cure76/EFHW-transformator-box/README.md

# Корпус трансформатора EFHW под FT 240-43

Параметрические модели OpenSCAD: основание и крышка унна 1:49 / 1:64. Печать **PETG**.

## Файлы

| Файл | Кольца | SO-239 | Полость | Предел |
| --- | --- | --- | --- | --- |
| `efhw_box.scad` | 1 × FT 240-43 | квадрат, 4 × M3 | 85 × 108 × 38 мм | 250 Вт SSB PEP, 120 Вт CW, 90 Вт FT8 |
| `efhw_box_rhomb.scad` | 1 × FT 240-43 | ромбический, 2 × M3, база 25 мм | 85 × 108 × 38 мм | 250 Вт SSB PEP, 120 Вт CW, 90 Вт FT8 |
| `efhw_box_2x.scad` | 2 × FT 240-43 стопкой | квадрат, 4 × M3 | 85 × 108 × 50 мм | 500 Вт SSB PEP, 250 Вт CW, 180 Вт FT8 |
| `efhw_box_2x_rhomb.scad` | 2 × FT 240-43 стопкой | ромбический, 2 × M3, база 25 мм | 85 × 108 × 50 мм | 500 Вт SSB PEP, 250 Вт CW, 180 Вт FT8 |

Без внешних библиотек.

- `part = "preview"` — сборка на экране
- `part = "base"` — основание
- `part = "lid"` — крышка (внутренней стороной на стол, надпись сверху)
- `part = "plug"` — заглушка неиспользуемого отверстия M4 (фланцем на стол)
- `ratio = 64` (по умолчанию) или `49` — на крышке `1:64` / `1:49` и строка мощности

## Полость

Одно кольцо: ПЭТВ-2 **1.25 мм**, запас под **1.5 мм**, фланец SO-239 25.4 мм. Габарит намотки Ø79 × 22 мм не должен задевать стойки.

Два кольца: та же ширина и длина, высота полости 50 мм под стопку 25.4 мм плюс намотка (ориентир Ø79 × 34 мм).

Кольца лежат плашмя, без клипс. По желанию — капля силикона в центр отверстия.

```
[хвост, 3 × Ø8 мм] [==== полость, кольцо плашмя ====] [SO-239 вниз]
                         [M4 сбоку ±Y, ближе к хвосту]
                         [крышка сверху, 4 × M4×10 потай]
                         [дренаж в торце SO-239]
```

В работе корпус висит за хвост, разъём смотрит вниз.

## Печать (PETG)

- Слой 0.2 мм, не меньше 3 периметров (стенка 2.8 мм)
- Основание: полостью вверх. Жёлоб, стойки и хвост — без поддержек
- Крышка 3.6 мм: внутренней стороной на стол, надпись и потай сверху. Утопление букв — в последних слоях
- Заглушка M4: фланцем на стол, стержень вверх, без поддержек
- Отверстия уже в модели, не сверлить после печати

Герметизация: валик нейтрального силикона в жёлобе плюс свес крышки как капельник. Нависающей юбки по шву нет.

## Саморезы крышки

Четыре **M4 × 10 с плоской потайной головкой 90°** (DIN 965 / ISO 7046). Длина 10 мм считается вместе со шляпкой; в крышке зенковка, шляпка заподлицо. Полукруглые и с прессшайбой в эту зенковку не сядут.

Пилот в стойках Ø 3.2 мм, под саморез в PETG, не под метрическую резьбу.

## Сборка

1. Вставить корпусной SO-239: квадратный фланец — 4 × M3, ромбический — 2 × M3 (в PETG только зазоры).
2. Вставить M4 изнутри через прилив на **одной** боковой стенке; снаружи шайба и гайка после пайки полотна. Второе отверстие закрыть заглушкой снаружи (фланец наружу); по желанию капля силикона под фланец.
3. Положить намотанное кольцо (или стопку).
4. Пайка: центральный пин, земля фланца, отвод на M4.
5. Валик нейтрального силикона в жёлоб по кромке.
6. Крышка, 4 самореза M4 × 10 с плоской (потайной) головкой в стойки (пилот Ø 3.2 мм). Шляпка заподлицо.
7. Два дренажных отверстия в торце SO-239 не замазывать.

Противовеса на корпусе нет.

## Мощность

| Файл | SSB PEP | CW | FT8 | Надпись на крышке |
| --- | --- | --- | --- | --- |
| `efhw_box.scad` | 250 Вт | 120 Вт | 90 Вт | `250W SSB PEP` |
| `efhw_box_rhomb.scad` | 250 Вт | 120 Вт | 90 Вт | `250W SSB PEP` |
| `efhw_box_2x.scad` | 500 Вт | 250 Вт | 180 Вт | `500W SSB PEP` |
| `efhw_box_2x_rhomb.scad` | 500 Вт | 250 Вт | 180 Вт | `500W SSB PEP` |

## Тесты

```bash
python3 tests/test_efhw_box.py
```

OpenSCAD CLI необязателен: без него проверки CSG/STL пропускаются.

## Лицензия

[BSD 3-Clause](LICENSE).
