cure76/EFHW-transformator-box/efhw_box.scad

// EFHW unun box for FT 240-43 — PETG FDM

part = "preview"; // "base" | "lid" | "plug" | "preview"
ratio = 64;       // 64 or 49

inner_x = 108;
inner_y = 85;
inner_z = 38;
wall = 2.8;
floor_t = 2.8;
lid_t = 3.6;              // thicker than walls so the 90° CSK is not a knife edge

// Top mating face must be wider than wall so a 4 mm trough fits.
rim_w = 7;
flange_out = rim_w - wall; // 4.2 mm outward lip
trough_w = 4;
trough_d = 1;

corner_r = 8;
chamfer = 14;
fit_clearance = 0.25;

// Four M4×10 countersunk (flat-head) self-tappers. Length includes the head.
boss_d = 12;
boss_pilot_d = 3.2;
boss_pilot_depth = 10;
lid_screw_d = 4.0;
lid_csink_d = 9.0;         // DIN 965 M4 head max 8.4 mm + print
lid_csink_h = 2.3;         // 90° CSK, flush in lid_t
skirt_t = 1.6;
skirt_gap = 0.3;

tab_len = 30;
tab_t = 8;                 // hanging plate thickness (was wall = 2.8)
tab_center_hole_d = 8;
tab_side_hole_d = 8;

drain_d = 3;
// Max |Y| on the flat +X face, hole fully on the wall (not on the 45° chamfer).
drain_y_off = inner_y / 2 - chamfer - drain_d / 2 - 1.5;

so_flange = 25.4;
so_hole_spacing = 18.2;
so_barrel_d = 16.3;
so_screw_d = 3.2;
so_pad_t = 2.5;

m4_d = 4.0;
m4_from_tail_inner = 18;
m4_toward_so239 = 5;       // along +X, toward the connector
m4_pad_t = 2;              // extra thickness inward, no hex pocket
m4_pad_d = 14;
m4_plug_flange_d = 10;
m4_plug_flange_t = 1.6;
m4_plug_press = 0.2;       // shaft over the cutout so the plug holds itself
m4_plug_extra_h = 2;       // extra length past the inner pad

// FR4 0.5 mm standoffs. M3×6 pan-head self-tappers; blind pilot, not through the floor.
fr4_boss_d = 16;
fr4_boss_h = 6;
fr4_pilot_d = 2.5;
fr4_pilot_depth = 4;
fr4_boss_x = 34;           // 80 mm jig, 6 mm from left/right
fr4_boss_y = 21.5;         // 55 mm jig, 6 mm from top/bottom
fr4_lid_clear = 0.5;       // keep pads off the lid-screw posts

label_depth = 0.6;
label_size_ratio = 12;
label_size_power = 6;

$fn = 48;

function outer_x() = inner_x + 2 * wall + 2 * flange_out;
function outer_y() = inner_y + 2 * wall + 2 * flange_out;
function wall_x() = inner_x + 2 * wall;
function wall_y() = inner_y + 2 * wall;
function base_h() = floor_t + inner_z;
function flange_h() = 3.0;
function boss_inset() = boss_d / 2 + 1.5;

// Same 1.5 mm gap to both faces of the corner as at the tail.
function so239_boss_xy(sy) =
    let (
        inset = boss_inset(),
        cy = sy * (inner_y / 2 - inset),
        cx = inner_x / 2 + inner_y / 2 - chamfer
            - abs(cy) - inset * sqrt(2)
    ) [cx, cy];

function tail_boss_xy(sy) =
    [-inner_x / 2 + boss_inset(), sy * (inner_y / 2 - boss_inset())];

function boss_centres() = [
    so239_boss_xy(1),
    so239_boss_xy(-1),
    tail_boss_xy(1),
    tail_boss_xy(-1)
];

module body_outline(h) {
    linear_extrude(height = h)
        offset(delta = wall + flange_out)
            chamfered_profile();
}

// Every mating perimeter is a true offset of this inner cavity profile.
module chamfered_profile() {
    inner_corner_r = max(0.1, corner_r - wall);
    offset(r = inner_corner_r)
        offset(delta = -inner_corner_r)
            polygon([
                [-inner_x / 2, -inner_y / 2],
                [ inner_x / 2 - chamfer, -inner_y / 2],
                [ inner_x / 2, -inner_y / 2 + chamfer],
                [ inner_x / 2,  inner_y / 2 - chamfer],
                [ inner_x / 2 - chamfer,  inner_y / 2],
                [-inner_x / 2,  inner_y / 2]
            ]);
}

module wall_outline(h) {
    linear_extrude(height = h)
        offset(delta = wall)
            chamfered_profile();
}

module inner_outline(h) {
    linear_extrude(height = h)
        chamfered_profile();
}

module cavity() {
    translate([0, 0, floor_t])
        inner_outline(inner_z + 1);
}

module fr4_bosses() {
    // Four pads on the floor for a 0.5 mm FR4 sheet. Screw heads sit outside
    // the FT 240 winding; the core rests on the sheet between them.
    // Same XY as the 80×55 mm drill jig (6 mm from every plate edge).
    // Pads are kept clear of the lid-screw posts.
    for (sx = [-1, 1], sy = [-1, 1]) {
        p = [sx * fr4_boss_x, sy * fr4_boss_y];
        difference() {
            translate([0, 0, floor_t - 0.02])
                linear_extrude(height = fr4_boss_h + 0.02)
                    intersection() {
                        chamfered_profile();
                        difference() {
                            translate(p)
                                circle(d = fr4_boss_d);
                            for (b = boss_centres())
                                translate(b)
                                    circle(d = boss_d + 2 * fr4_lid_clear);
                        }
                    }
            translate([p[0], p[1], floor_t + fr4_boss_h - fr4_pilot_depth])
                cylinder(d = fr4_pilot_d, h = fr4_pilot_depth + 0.2);
        }
    }
}

module screw_bosses() {
    h = inner_z - trough_d;
    // Kite: boss circle plus two tangent ramps to the adjacent walls.
    // Anchors are points, not boss-diameter circles — a fat circle on the
    // +X chamfer vertex used to cover the drain mouths.
    posts = [
        [so239_boss_xy(1), [
            [inner_x / 2 - chamfer,  inner_y / 2],
            [inner_x / 2,            inner_y / 2 - chamfer]
        ]],
        [so239_boss_xy(-1), [
            [inner_x / 2 - chamfer, -inner_y / 2],
            [inner_x / 2,           -inner_y / 2 + chamfer]
        ]],
        [tail_boss_xy(1),  [[-inner_x / 2,  inner_y / 2]]],
        [tail_boss_xy(-1), [[-inner_x / 2, -inner_y / 2]]]
    ];

    for (post = posts) {
        pos = post[0];
        anchors = post[1];
        difference() {
            translate([0, 0, floor_t - 0.02])
                linear_extrude(height = h + 0.02)
                    intersection() {
                        chamfered_profile();
                        hull() {
                            translate(pos)
                                circle(d = boss_d);
                            for (a = anchors)
                                translate(a)
                                    circle(d = 0.02);
                        }
                    }
            translate([pos[0], pos[1], floor_t + h - boss_pilot_depth])
                cylinder(d = boss_pilot_d, h = boss_pilot_depth + 0.2);
        }
    }
}

module sealant_trough() {
    land = (rim_w - trough_w) / 2;
    translate([0, 0, base_h() - trough_d])
        difference() {
            linear_extrude(height = trough_d + 0.2)
                offset(delta = wall + flange_out - land)
                    chamfered_profile();
            linear_extrude(height = trough_d + 0.4)
                offset(delta = wall + flange_out - land - trough_w)
                    chamfered_profile();
        }
}

module mounting_tab() {
    // Full-width rear flange, thicker than the wall, clover tip with 3 holes.
    x_wall = -wall_x() / 2;
    x_tip = x_wall - tab_len;
    y_h = wall_y() / 2;
    side_y = y_h - 12;

    difference() {
        hull() {
            // Root spans the whole −X wall and bites into it.
            translate([x_wall + 4, 0, tab_t / 2])
                cube([8, wall_y(), tab_t], center = true);
            translate([x_wall, y_h - 8, 0])
                cylinder(d = 16, h = tab_t);
            translate([x_wall, -y_h + 8, 0])
                cylinder(d = 16, h = tab_t);
            // Rounded clover across the full width.
            translate([x_tip + 12, 0, 0])
                cylinder(d = 24, h = tab_t);
            translate([x_tip + 14, side_y, 0])
                cylinder(d = 20, h = tab_t);
            translate([x_tip + 14, -side_y, 0])
                cylinder(d = 20, h = tab_t);
        }
        translate([x_tip + 11, 0, -0.1])
            cylinder(d = tab_center_hole_d, h = tab_t + 0.2);
        translate([x_tip + 14, side_y, -0.1])
            cylinder(d = tab_side_hole_d, h = tab_t + 0.2);
        translate([x_tip + 14, -side_y, -0.1])
            cylinder(d = tab_side_hole_d, h = tab_t + 0.2);
    }
}

module drain_holes() {
    // Through the SO-239 end wall, left and right of the connector.
    // When the box hangs from the tab, that face is the lowest point.
    zc = floor_t + inner_z / 2;
    x_wall = inner_x / 2;
    for (s = [-1, 1]) {
        translate([x_wall - 1, s * drain_y_off, zc])
            rotate([0, 90, 0])
                cylinder(d = drain_d, h = wall + 2);
        translate([x_wall + wall + 0.01, s * drain_y_off, zc])
            rotate([0, -90, 0])
                cylinder(d1 = drain_d + 2, d2 = drain_d, h = 1.2);
    }
}

module so239_cutout() {
    zc = floor_t + inner_z / 2;
    x_wall = inner_x / 2;
    barrel = so_barrel_d + 2 * fit_clearance;
    screw = so_screw_d + 2 * fit_clearance;
    hs = so_hole_spacing / 2;
    through_h = so_pad_t + wall + 2;

    // Barrel through the inward pad and 2.8 mm +X wall.
    translate([x_wall - so_pad_t - 1, 0, zc])
        rotate([0, 90, 0])
            cylinder(d = barrel, h = through_h);
    // Four M3 clearance holes matching the square SO-239 flange.
    for (a = [-1, 1], b = [-1, 1]) {
        translate([x_wall - so_pad_t - 1, a * hs, zc + b * hs])
            rotate([0, 90, 0])
                cylinder(d = screw, h = through_h);
    }
}

module so239_pad() {
    zc = floor_t + inner_z / 2;
    x_wall = inner_x / 2;
    pad_size = so_flange + 0.4;

    // Full flange seat grows inward from the +X wall into the cavity.
    translate([x_wall - so_pad_t, -pad_size / 2, zc - pad_size / 2])
        cube([so_pad_t + 0.01, pad_size, pad_size]);
}

module m4_pad() {
    zc = floor_t + inner_z / 2;
    x = -inner_x / 2 + m4_from_tail_inner + m4_toward_so239;

    // Inward bosses on both ±Y walls; holes are cut later through pad + wall.
    for (sy = [-1, 1]) {
        y_inner = sy * inner_y / 2;
        translate([x, y_inner + sy * 0.01, zc])
            rotate([sy * 90, 0, 0])
                cylinder(d = m4_pad_d, h = m4_pad_t + 0.01);
    }
}

module m4_cutout() {
    zc = floor_t + inner_z / 2;
    x = -inner_x / 2 + m4_from_tail_inner + m4_toward_so239;
    shank = m4_d + 2 * fit_clearance;
    through_h = wall + m4_pad_t + 2;

    for (sy = [-1, 1]) {
        y_inner = sy * inner_y / 2;
        translate([x, y_inner + sy * (wall + 1), zc])
            rotate([sy * 90, 0, 0])
                cylinder(d = shank, h = through_h);
    }
}

module m4_plug() {
    // Print flange on the bed, shaft up. Push in from outside; flange sheds rain.
    // Shaft is a press fit in the M4 cutout; a short taper starts the insertion.
    hole = m4_d + 2 * fit_clearance;
    shaft = hole + m4_plug_press;
    shaft_h = wall + m4_pad_t + m4_plug_extra_h;
    cylinder(d = m4_plug_flange_d, h = m4_plug_flange_t);
    translate([0, 0, m4_plug_flange_t - 0.01])
        cylinder(d = shaft, h = shaft_h + 0.01);
    translate([0, 0, m4_plug_flange_t + shaft_h - 0.01])
        cylinder(d1 = shaft, d2 = hole - 0.3, h = 1.5);
}

module m4_plug_on_wall(sy) {
    x = -inner_x / 2 + m4_from_tail_inner + m4_toward_so239;
    zc = floor_t + inner_z / 2;
    y_outer = sy * (inner_y / 2 + wall);
    translate([x, y_outer, zc])
        rotate([sy * 90, 0, 0])
            translate([0, 0, -m4_plug_flange_t])
                m4_plug();
}

module lid_label() {
    // Recessed into the outer face. Readable when tail (−X) is up:
    // rotate 90° so the baseline runs across the short axis, top of glyphs
    // toward −X.
    linear_extrude(height = label_depth + 0.1) {
        rotate([0, 0, 90]) {
            translate([0, 4, 0])
                text(
                    str("1:", ratio),
                    size = label_size_ratio,
                    halign = "center",
                    valign = "center"
                );
            translate([0, -8, 0])
                text(
                    "250W SSB PEP",
                    size = label_size_power,
                    halign = "center",
                    valign = "center"
                );
        }
    }
}

module so239_rim_clearance() {
    // Drop the outward lid-rim on the +X face so a 25.4 mm flange sits flat.
    w = so_flange + 6;
    translate([inner_x / 2 + wall, -w / 2, -0.1])
        cube([flange_out + 1, w, base_h() - flange_h() + 0.1]);
}

module base() {
    difference() {
        union() {
            difference() {
                wall_outline(base_h());
                cavity();
            }
            // Outward flange at the rim so trough_w=4 fits on a 2.8 mm wall.
            translate([0, 0, base_h() - flange_h()])
                difference() {
                    body_outline(flange_h());
                    inner_outline(flange_h() + 0.2);
                }
            screw_bosses();
            fr4_bosses();
            so239_pad();
            m4_pad();
        }
        sealant_trough();
        so239_rim_clearance();
        drain_holes();
        so239_cutout();
        m4_cutout();
    }
    mounting_tab();
}

module lid_shell() {
    difference() {
        // Plate overhangs the flange as a drip cap; there is no hanging wall.
        linear_extrude(height = lid_t)
            offset(delta = skirt_t + skirt_gap)
                projection() body_outline(1);
        lid_screw_holes();
        translate([0, 0, lid_t - label_depth])
            lid_label();
    }
}

module lid_screw_holes() {
    for (p = boss_centres()) {
        shank = lid_screw_d + 2 * fit_clearance;
        translate([p[0], p[1], -0.1])
            cylinder(d = shank, h = lid_t + 0.2);
        // 90° cone from the through-hole out to the flat head.
        translate([p[0], p[1], lid_t - lid_csink_h])
            cylinder(d1 = shank, d2 = lid_csink_d, h = lid_csink_h + 0.05);
    }
}

module lid() {
    lid_shell();
}

module preview_assembly() {
    color("DimGray") base();
    color("Gray")
        translate([0, 0, base_h() + 0.15])
            lid_shell();
    // Spare M4 hole on +Y closed by the printed plug; −Y is the radiator bolt.
    color("Orange") m4_plug_on_wall(1);
}

if (part == "base") {
    base();
} else if (part == "lid") {
    lid();
} else if (part == "plug") {
    m4_plug();
} else if (part == "preview") {
    preview_assembly();
}
