cure76/EFHW-transformator-box/(list of files, cad)

Other CAD files:
efhw_box_2x.scad
efhw_box_2x_rhomb.scad
efhw_box_rhomb.scad
