cure76/EFHW-transformator-box/(commit log)

2026-09-01 Add EFHW box OpenSCAD scaffold and parameter tests.
    [efhw_box.scad]
2026-09-01 Model the box body, cavity, bosses, and sealant trough.
    [efhw_box.scad]
2026-09-01 Fix wall and trough perimeter geometry.
    [efhw_box.scad]
2026-09-01 Fix cavity and boss chamfer geometry.
    [efhw_box.scad]
2026-09-01 Derive shell perimeters from the inner profile.
    [efhw_box.scad]
2026-09-01 Add clover hanging tab and SO-239-end drain holes.
    [efhw_box.scad]
2026-09-01 Cut SO-239 flange seat and inside-out M4 terminal.
    [efhw_box.scad]
2026-09-01 Fix SO-239 flange seat orientation.
    [efhw_box.scad]
2026-09-01 Fix M4 pocket opening direction.
    [efhw_box.scad]
2026-09-01 Add lid with rain skirt and countersunk screw holes.
    [efhw_box.scad]
2026-09-01 Connect lid plate to rain skirt.
    [efhw_box.scad]
2026-09-01 Add lid ratio label, print notes, and STL export checks.
    [efhw_box.scad]
2026-09-01 Fix lid preview and drip cap geometry.
    Keep the lid in print orientation during previews and remove the label-side fence so the plate overhang provides the intended weather protection.
    [efhw_box.scad]
2026-09-01 Prepare a public GitHub tree for the FT 240-43 box.
    Drop internal SDD docs, add .gitignore, and record the hanging tab, SO-239-end drains, and cavity height that the printed model actually uses.
    [efhw_box.scad]
2026-09-01 Size the lid for M4×10 countersunk self-tappers.
    Document DIN 965 / ISO 7046 flat heads in the README so the print matches the screws on hand.
    [efhw_box.scad]
2026-09-01 Blend lid bosses into the corners and thicken the side M4 seat.
    Fill posts inside the inner profile so they do not poke through the chamfer, drop the hex pocket, and shift the radiator bolt 5 mm toward SO-239.
    [efhw_box.scad]
2026-09-01 State the SSB, CW, and FT8 power limits without extra conditions.
2026-09-07 Add stacked-core and rhombic boxes plus a spare-side M4 plug.
    Four models share the same enclosure; corner posts use tangent ramps so hanging condensate reaches the drains, and the unused radiator hole gets a printed plug.
    [efhw_box_2x.scad, efhw_box_2x_rhomb.scad, efhw_box_rhomb.scad]
2026-09-09 Keep the ferrite off the PETG floor with FR4 standoff pads.
    New prints get four M3 pads in the base; already-printed boxes get through-bolt spacers and a drill jig.
    [efhw_box.scad, efhw_box_2x.scad, efhw_box_2x_rhomb.scad, efhw_box_rhomb.scad, efhw_fr4_standoff.scad]
2026-09-10 Press-fit the spare M4 plug and align FR4 pads to a rectangular drill jig.
    [efhw_box.scad, efhw_box_2x.scad, efhw_box_2x_rhomb.scad, efhw_box_rhomb.scad, efhw_fr4_standoff.scad]
